jdemeyer1/SelfieMission/MissionImages/20190820 Highest Selfie.png

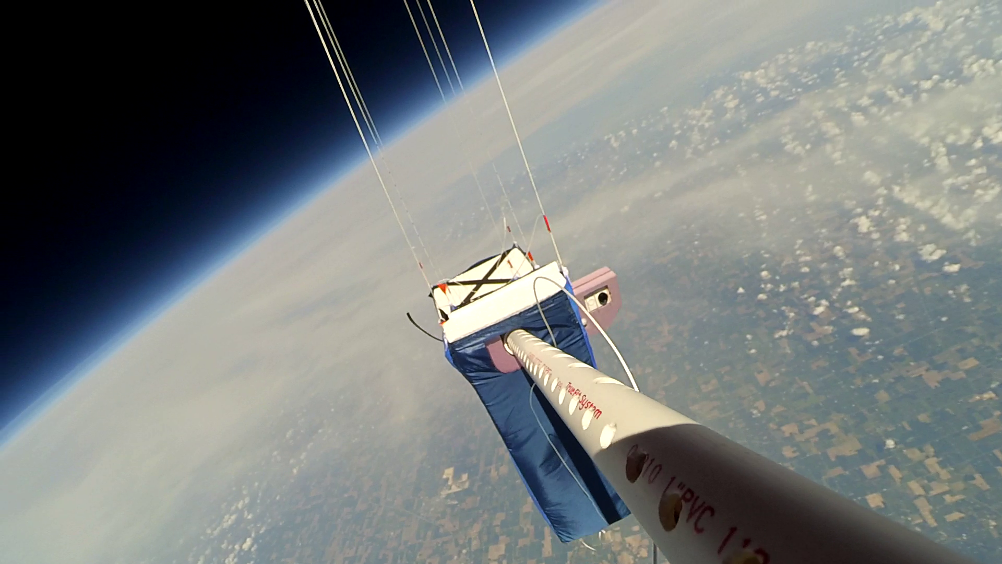
MissionImages/20190820 Highest Selfie.png
