jdemeyer1/SelfieMission/Payload Cut Down/PayloadCutDownSchematic.png

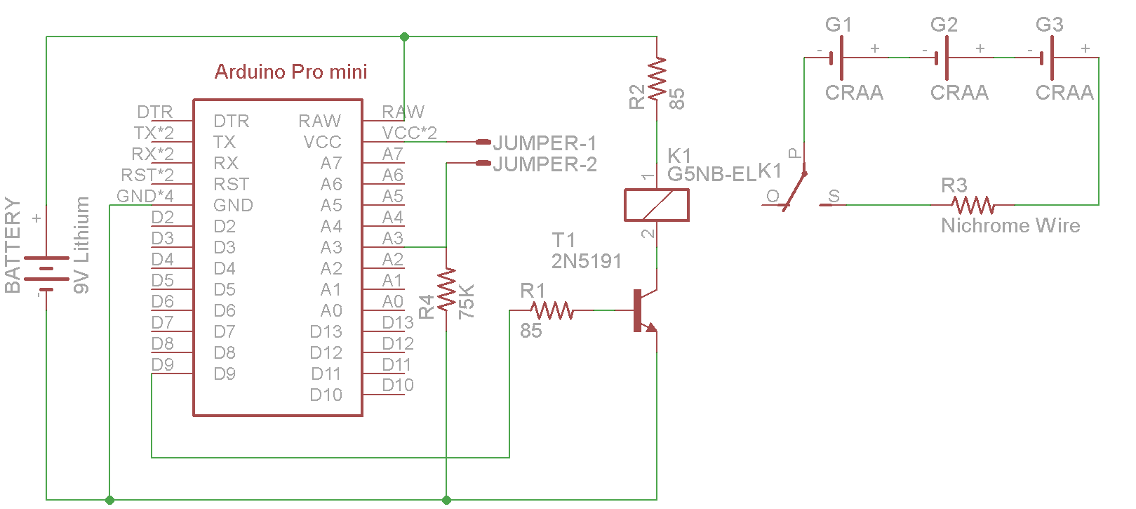
Payload Cut Down/PayloadCutDownSchematic.png
