jdemeyer1/SelfieMission/Selfie Base Station/SelfieBaseStation.png

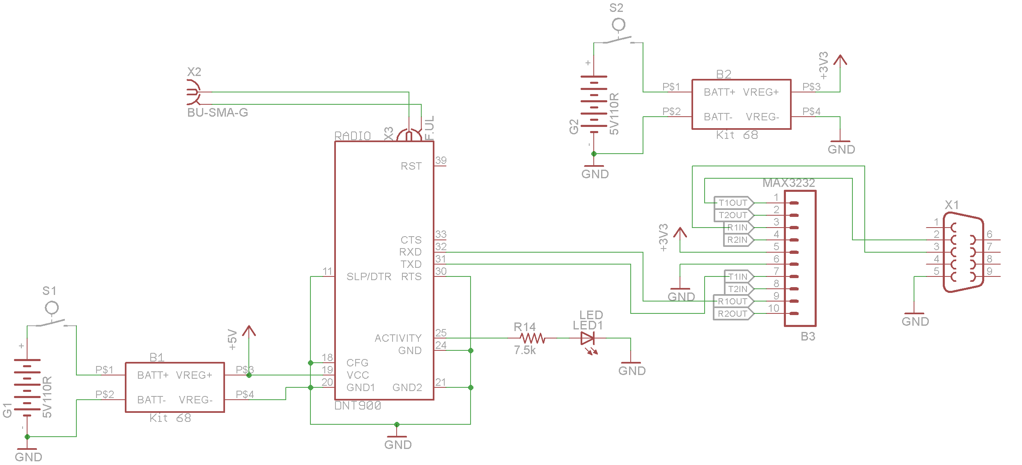
Selfie Base Station/SelfieBaseStation.png
