jdemeyer1/SelfieMission/Selfie Flight Computer/SelfieFlightComputerSchematic.png

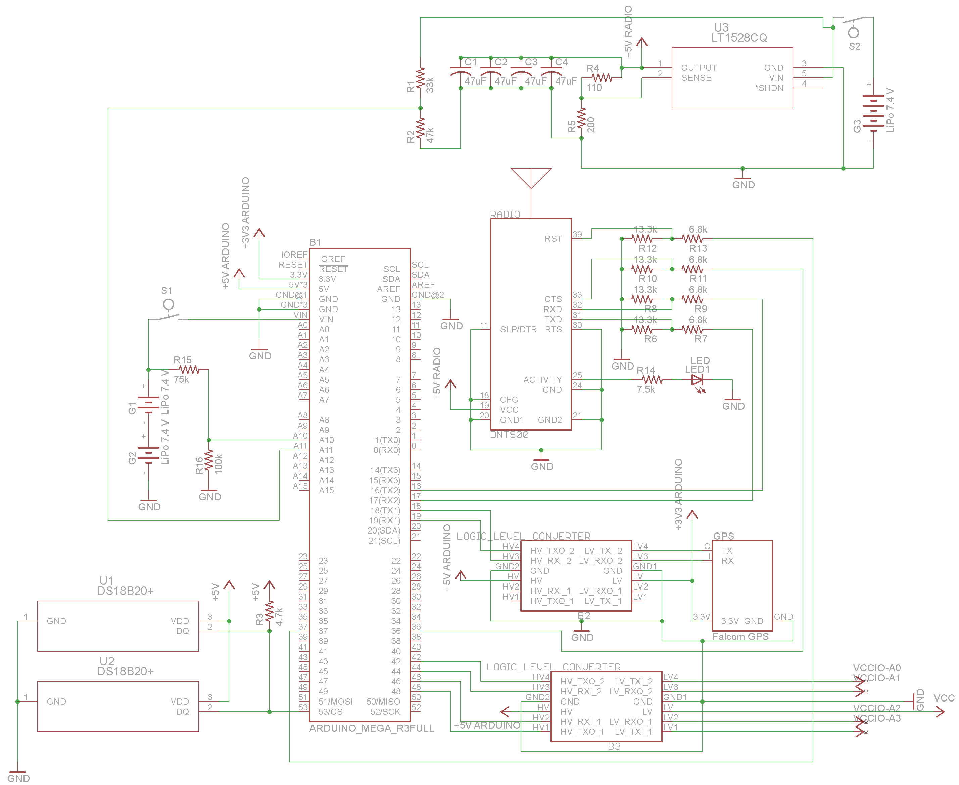
Selfie Flight Computer/SelfieFlightComputerSchematic.png
