jdemeyer1/SelfieMission/Selfie Module/Selfie Arduino IDE Settings.bmp

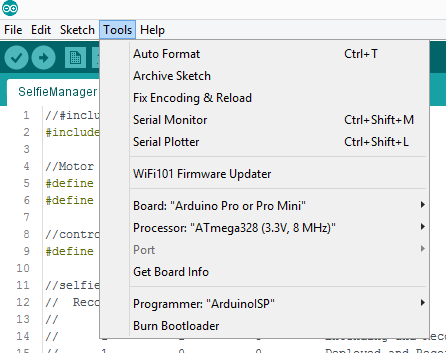
Selfie Module/Selfie Arduino IDE Settings.bmp
