jdemeyer1/SelfieMission/Selfie Module/SelfieModuleSchematic.png

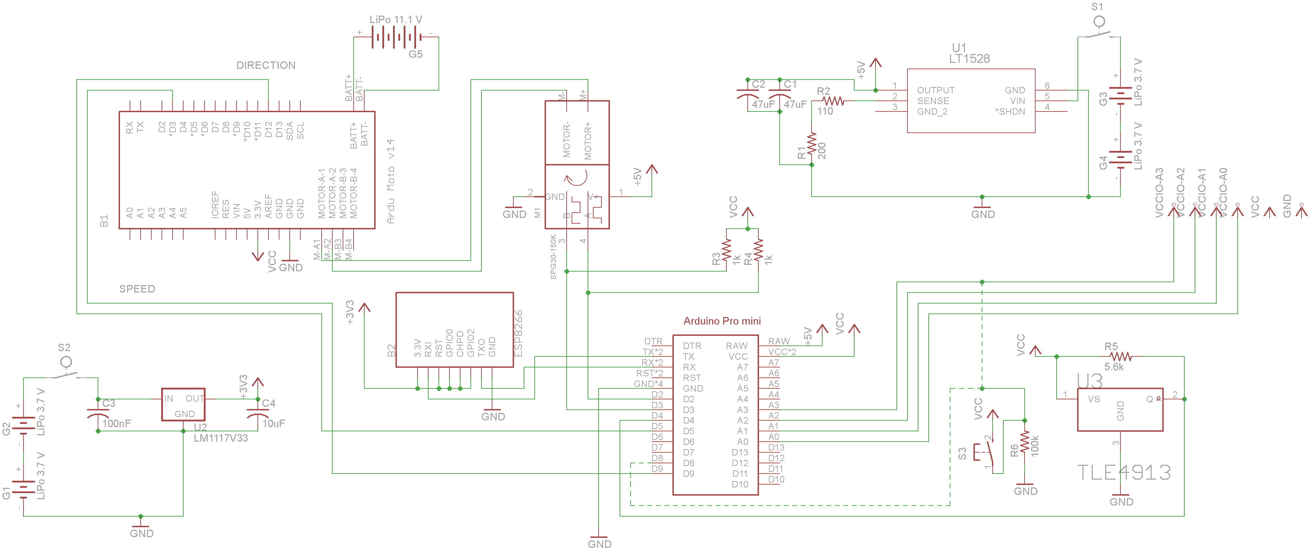
Selfie Module/SelfieModuleSchematic.png
