jdemeyer1/SelfieMission/(commit log)

2020-11-12 schematic files added
2020-11-14 BOM added
